Hartland/C64-Keyboard/Version 2 BETA/Docs/KEY HEADER TO CROSS SWITCH.pdf

C64 Keyboard Header Pin | Coordinate | MT8808 | MT8812/16
01 | GND | N/A | N/A
02 | N/C | N/C | N/C
03 | NMI | N/A | N/A
04 | +5V | N/A | N/A
05 | Y3 | 15 | 01
06 | Y6 | 12 | 17
07 | Y5 | 13 | 19
08 | Y4 | 14 | 21
09 | Y7 | 11 | 15
10 | Y2 | 16 | 39
11 | Y1 | 17 | 37
12 | Y0 | 18 | 35
13 | X0 | 06 | 33
14 | X6 | 09 | 08
15 | X5 | 21 | 28
16 | X4 | 08 | 29
17 | X3 | 22 | 30
18 | X2 | 07 | 31
19 | X1 | 23 | 32
20 | X7 | 20 | 09
