Hartland/C64-Keyboard/Version 2 BETA/Docs/NonAlphaNumKeys.PDF

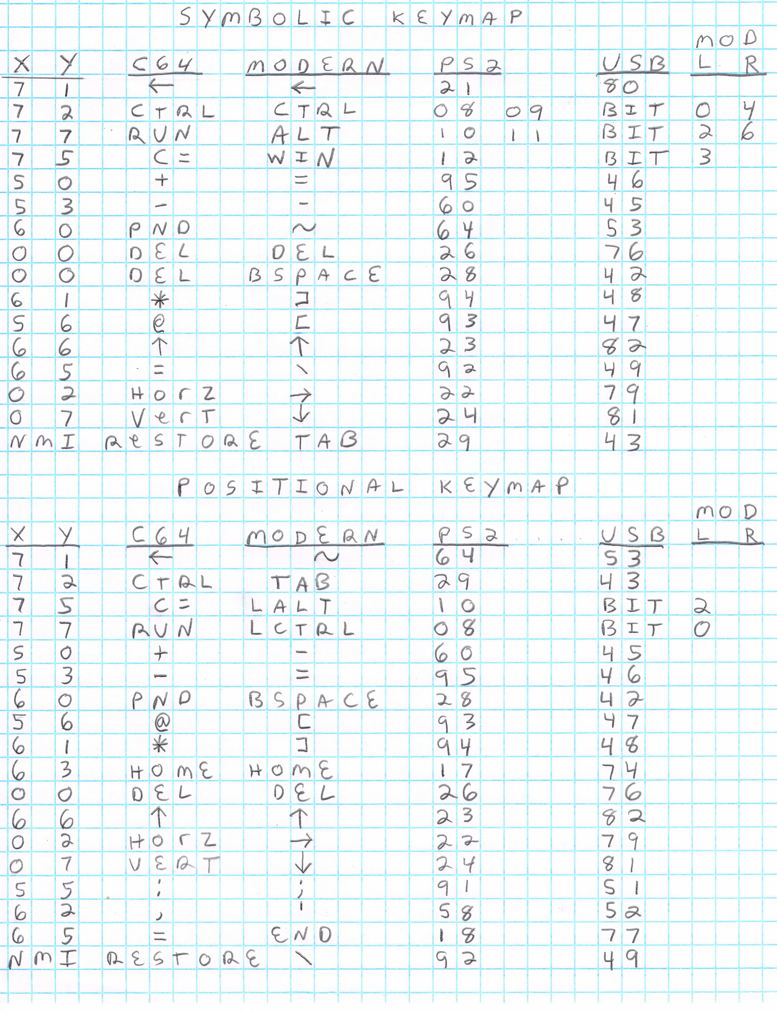
[picture p1: page 1]
