Hartland/C64-Keyboard/Version 2 BETA/Docs/PS2KeyAdvanced_Codes.PDF

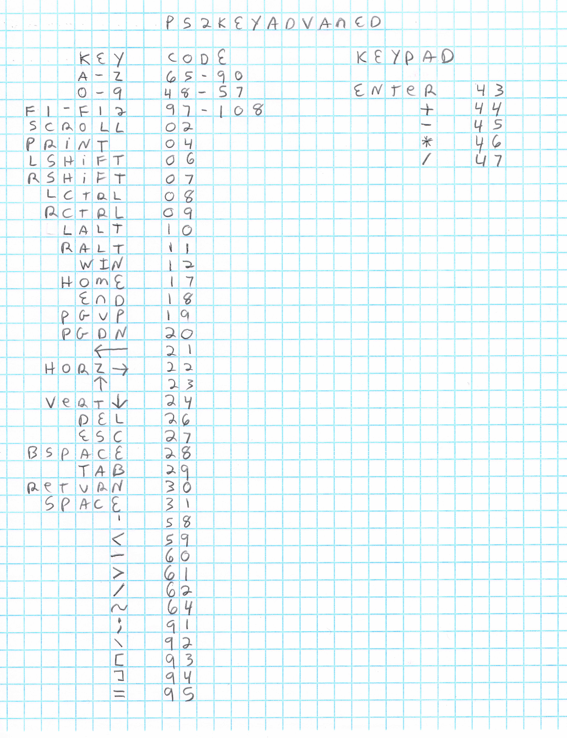
[picture p2: page 1]
