Hartland/C64-Keyboard/Version 2 BETA/Docs/KEY COORDINATES.pdf

KEY | AX | AY A | 1 | 2 B | 3 | 4 C | 2 | 4 D | 2 | 2 E | 1 | 6 F | 2 | 5 G | 3 | 2 H | 3 | 5 I | 4 | 1 J | 4 | 2 K | 4 | 5 L | 5 | 2 M | 4 | 4 N | 4 | 7 O | 4 | 6 P | 5 | 1 Q | 7 | 6 R | 2 | 1 S | 1 | 5 T | 2 | 6 U | 3 | 6 V | 3 | 7 W | 1 | 7 X | 2 | 7 Y | 3 | 1 Z | 1 | 4 0 | 4 | 3 1 | 7 | 0 2 | 7 | 3 3 | 1 | 0 4 | 1 | 3 5 | 2 | 0 6 | 2 | 3 7 | 3 | 0 8 | 3 | 3 9 | 4 | 0

KEY | AX | AY
HORZ CURSOR | 0 | 2
VERT CURSOR | 0 | 7
F1 | 0 | 4
F3 | 0 | 5
F5 | 0 | 6
F7 | 0 | 3
HOME | 6 | 3
UP ARROW | 6 | 6
= | 6 | 5
RIGHT SHIFT | 6 | 4
/ | 6
7 ; | 6 | 2 * | 6 | 1 . | 5 | 4 @ | 5 | 6 : | 5 | 5 + | 5 | 0 - | 5 | 3 , | 5 | 7
CTRL | 7 | 2
RUN/STOP | 7 | 7
SPACE | 7 | 4
C= | 7 | 5
LEFT SHIFT | 1 | 7
BACK ARROW | 7 | 1
DELETE | 0 | 0
RETURN | 0 | 1
POUND | 6 | 0
