Hartland/C64-Keyboard/Version 2 BETA/Docs/PS2KeyAdvanced_Codes.JPG

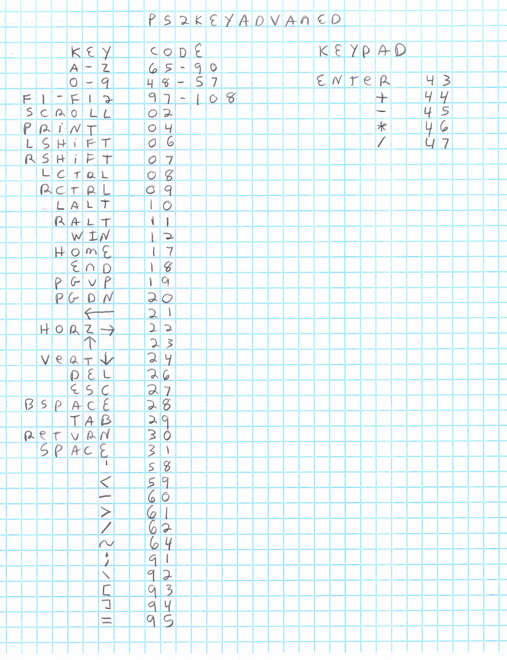
Version 2 BETA/Docs/PS2KeyAdvanced_Codes.JPG
