Hartland/C64-Keyboard/Version 2 BETA/Wiring difference.txt

This document is obsolete.

The MT88xx library now uses direct pin assignment for the address pins.

The current version of the PS/2 C64 keyboard sketch will work on current PCBs.

It has been tested with the shared C64 keyboard PCB from PCBWAY
