Hartland/C64-Keyboard/(threads)

Thread 1 (2020-01-11):

Build errors

StormTrooper, 2020-01-11:
Found a small error:
In the file C64-Keyboard/USB/C64_keyboard/C64_keyboard.ino you include:
"C64Keyboard.h"

It should "C64keyboard.h"

Hartland, 2020-01-14:
Filename case issue resolved in latest commit.
I did not discover due to Windows being agnostic to letter case in file names.

Thanks for the catch.

Closed 2020-01-14.

Thread 2 (2024-01-07):

PS/2 keyboard init problems

c1570, 2024-01-07:
It seems I'm stumbled upon a PS/2 keyboard (a cheap "Labtec 867571-0102") that has some issues with the startup timing.

Setup: ATmega8, 8MHz internal clock, 64ms startup, 4V BOD, rather long power lines.

Symptom:

- power on the adapter
- press a key
- data line goes and stays low, adapter seems to hang
- resetting the ATmega8 (pull pin 1 to GND briefly) with power kept on makes things work again.

I suspect the problem is power related as this doesn't happen that often with very strong power supply/very short power lines. Perhaps the ATmega powers on much before the keyboard does, bringing them out of sync or similar.

In any case, disabling the setLock() call in resetMT8808() seems to fix the issue. I suspect delaying that somewhat would also be fine.

banman11, 2024-03-11:
Hi c1570,

Yes, I have found a few keyboards that have the same issue.
Just some random thoughts......

I found that unplugging the keyboard from the adaptor while the adaptor is plugged in to the c64 main board and powerd on seems to resolve my issue of the keyboard 'not being seen'.
The issue presents itself on several VIC 20's
, C64's, and a c16 that I tested.
I tried different external crystal speeds and internal speed configurations.
It must lay in the way the PS2/ USB keyboard communicates.
I had thought of putting in a push button along the 5v line to the PS2 / USB keyboard. When depressed would cut the power and hopefully reinitialise the keyboard after the Arduino microcontroller had a chance to boot up and become ready to process data.

Hartland, 2024-03-11:
It appears in the latest version of schematics, I omitted the bypass capacitor.
Placing a 100NF (.1uf) capacitor between VCC and ground can help with some of the glitching.

I will correct in the next revision. i will be revisiting the project this year and I am looking to include PCB transfers and possible fix for power up key detection.

banman11, 2024-03-12:
Hi Hartland,

Thanks for the prompt response. This is a great project. I see quite a few PS2/USB keyboard to C64 builders have used your code.

I wondered if I could ask for some advice. I don't see a questions tab in this GitHub profile. Only an issues tab. Could I use the issues tab to ask for advice or is there a better way?

I will look forward to seeing your next revision.

Regards..

sarumpaet, 2024-03-12:
> It appears in the latest version of schematics, I omitted the bypass capacitor.
> Placing a 100NF (.1uf) capacitor between VCC and ground can help with some of the glitching.

I forgot to mention that I already added additional capacitors to rule that out.

It looks like the PS2KeyAdvanced lib goes into some weird state in case setLock() gets called before the keyboard is actually ready. I haven't investigated further, but it looks like one has to wait for the 0xAA/BAT message from the keyboard after power on before sending control codes.

c1570, 2024-03-12:
> It appears in the latest version of schematics, I omitted the bypass capacitor.
> Placing a 100NF (.1uf) capacitor between VCC and ground can help with some of the glitching.

I forgot to mention that I already added additional capacitors to rule that out.

It looks like the PS2KeyAdvanced lib goes into some weird state in case setLock() gets called before the keyboard is actually ready. I suspect one has to wait for the 0xAA/BAT message from the keyboard after power on before sending control codes.

Hartland, 2024-03-16:
Banman11,

I believe the discussion tab is now available.

Responses may be a bit slow as my day job is entering the busier season.

As for the keyboard issue, has anybody tried to add a delay before ps2advanced is loaded?
I am in the process of getting my C64 project bench setup up and running, while finishing off a couple of my personal projects, so I have not been able to look directly into this.
Also, could you give me some model numbers of the keyboards that are having issues. i have not encountered this issue with any keyboards I have used and I will need to get one of the model keyboards that are having this issue.

banman11, 2024-03-17:
Hi Hartland,

First of all I would like to you for this great project.

Much appreciated for adding the discussion tab.😁

No, I haven't added a delay before the ps2advanced is loaded. This may actually be a good way to check it.
I have a theory that some of the keyboards I tested needed some type of delay.

I must apologise, I am a very mediocre hobbyist at best.
What would the code snippet look like if a delay were added.

I definitely will let you know the types of keyboard that works and doesn't work.
I did notice that some USB keyboards functioned perfectly fine with the PS2 programmed firmware.
So I would say that some USB keyboards use PS2 style protocols.

A few of us started this thread....

https://www.melon64.com/forum/viewtopic.php?t=15160&hilit=Usb+keyboard

We had tried to contact you some time ago to get permission to use your project. However we got no reply.
I do apologize very much if we have done the wrong thing. We can pull the thread down if you wish. Please let us know. We would be happy to comply.

Hartland, 2024-04-20:
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

No issues, I always meant this project to be available to all hobbyists. In fact ,I will be changing to a MIT license during the updates planned this year.
I have tried to register at melon64 a couple of times, but I never receive the email verification. Perhaps give the admin a poke to check out the verification system.

Also, I have published the overall plan this year in the discussion forum.

banman11, 2024-04-21:
Hello Heartland,

Thank you very much for your blessing.

It would absolutely be our pleasure if you would join us on Melon64. It would be a great opportunity for us hobbyist's have your views and inputs. There are so many things I want to know regarding your great work. Melon64 is a good easy forum for off the cuff discussion of things with an incline towards retro computer related stuff.
I will see what I can do about resolving your login verification issues.
I am sure it is some minor clerical technicality. I'll get back to you.

Thanks again for a great project.

Hartland, 2024-04-25:
Quick update on the issue itself.
I recently bought a 2nd PS/2 keyboard for backup. I have learned it can be easy to fry a PS/2 keyboard through the development of the project.
It turns out the new keyboard exhibits the issue described.

It appears it is an issue with PS2key advanced itself. The same issue arises when just the library with its included example, at least with the UNO. I remember testing it the DUE and it worked, but I am going to need to explore further.
The new keyboard works fine on a computer and the old keyboard works with PS/2 key advanced with no changes to the UNO.

It looks like I might need to "adjust" another library. In this case maybe fix an issue the library writers refuse to acknowledge and seem to push issue on the user.
It is still possible I may be at fault, but with the simple test of old and new keyboard on the same UNO with no changes, it seems unlikely,

banman11, 2024-04-26:
Hi Hartland,

Well, I can say I that I haven't had and issues with breaking any keyboards using your current circuit layout.
I even accidentally reversed the pin header on a C16 Commodore computer and absolutely nothing untoward happens. However, I absolutely don't recommend that one tries this of course.

At the time I thought the C16 machine is finished.

I would hazard a guess the crosspoint IC chip you have implemented has safety cutoff features.
That's a sign of good engineering, thanks.

Hartland, 2024-04-26:
Sorry for any confusion my previous posted caused. I was only commenting on the frailty of some PS/2 keyboards i have experienced in the past, nothing to do with recent activity.

I am most probably incorrect about the delay, I do not think it will fix anything. There may be some timing issues, but for now out that aside.

I have discovered 2 issues:

In terms of initialization, there may be voltage problems. The new keyboard will not initialize correctly at 5V but will initialize at 5.25V. These are measurements on the power supply and multi-meter at PS/2 connector.

The newer keyboard  appears to send twice as much data per key press then the older keyboard. There are several variations on the PS/2 scan code sets even within the sets themselves.

I will keep you posted as developments occur.

Hartland, 2024-04-27:
Update:

I have figured out the base difference between the PS/2 keyboards that work with any of the PS/2 libraries I have tested and those that do not.

USB compatibility is the difference.

Internally, keyboards that are strictly PS/2 work fine. Those that work with both USB and PS/2, including those that have wired PS/2 connectors, have issues with deciding what protocol to use.

When using a dual protocol keyboard:

1. At 5.25V the keyboard will initialize with PS/2. However, it sends what appears to be corrupted/random data that is different each time regards of key press. It appears this is USB packet data.

2. Using a PS/2 breakout board and connecting to a computer through USB results in a fully functional USB keyboard. Normal power though USB is used.

3. Connecting both USB to computer and PS/2 to micro controller at the same time results in no USB connection but a stable PS/2 connection (though the key-codes are a bit odd, could be a code set issue). No extra data, just normal make/break packets. Again, normal USB power is used.

Updates to continue, when I figure out more.

c1570, 2024-04-28:
@Hartland Not sure if your findings are actually related to the original description of this issue. Have you tried removing the setLock() call in resetMT8808() ? If that fixes the issue, then it's clearly related, if not, a new issue should get opened.

Perhaps the early setLock() call triggers some USB detection on keyboard side? And that only happens if - due to supply voltage/power line length/resistance - the keyboard is a bit late when initializing?

Hartland, 2024-04-28:
I deleted a few of my posts as they are no longer relevant and do not provide useful information. I have a tendency to share in my troubleshooting process in hopes of somebody will have some helpful insights.  After tentatively fixing the issue, I thought it appropriate to cleanup a bit.

I believe I have a solution to the PS/2 initialization issue that may or may not be be related to this issue.

On certain PS/2 - USB combo keyboards, including those with only a wired PS/2 connector, there appears to be something different with the pull-up resistance on both data and clock lines. Whether or not the micro-controller has the pins set as pull-up makes no difference.
Installing 4.7K or 10K pull-up resistors(again regardless of the micro-controller settings) fixes the initialization and protocol issue.
Some keyboards still seem to send extra packets when a key is held down, but I will investigate and issue a fix if needed.

For those unfamiliar with pull up resistors, it is simply adding a resistor from V+ to clock and data pins separately (each pin has its own resistor).

If this does not help with the OP issue, I will separate this into a new issue.

banman11, 2024-04-29:
Hi Heartland,

Very interesting!
I think I have a few keyboards that have a USB cable which will work on the PS2 programmed adapter after I disconect and reconnect the keyboard cable while the adapter 8s powered up.

Thank you for the tip on using the 4.7k -10k Ohm pullup resistor between the + 5v power rail and the Clock and Data separately.

I'll get back to you with my observations.

Thanks

Hartland, 2024-06-06:
As mentioned in in the discussion post, I found that 220 ohm resistors work best. At least with the keyboard I experimented with, that value really brought it under control and working smoothly.
