Hartland/C64-Keyboard/Version 1/PS2/Arduino Uno-Nano MT8808 schematic.pdf

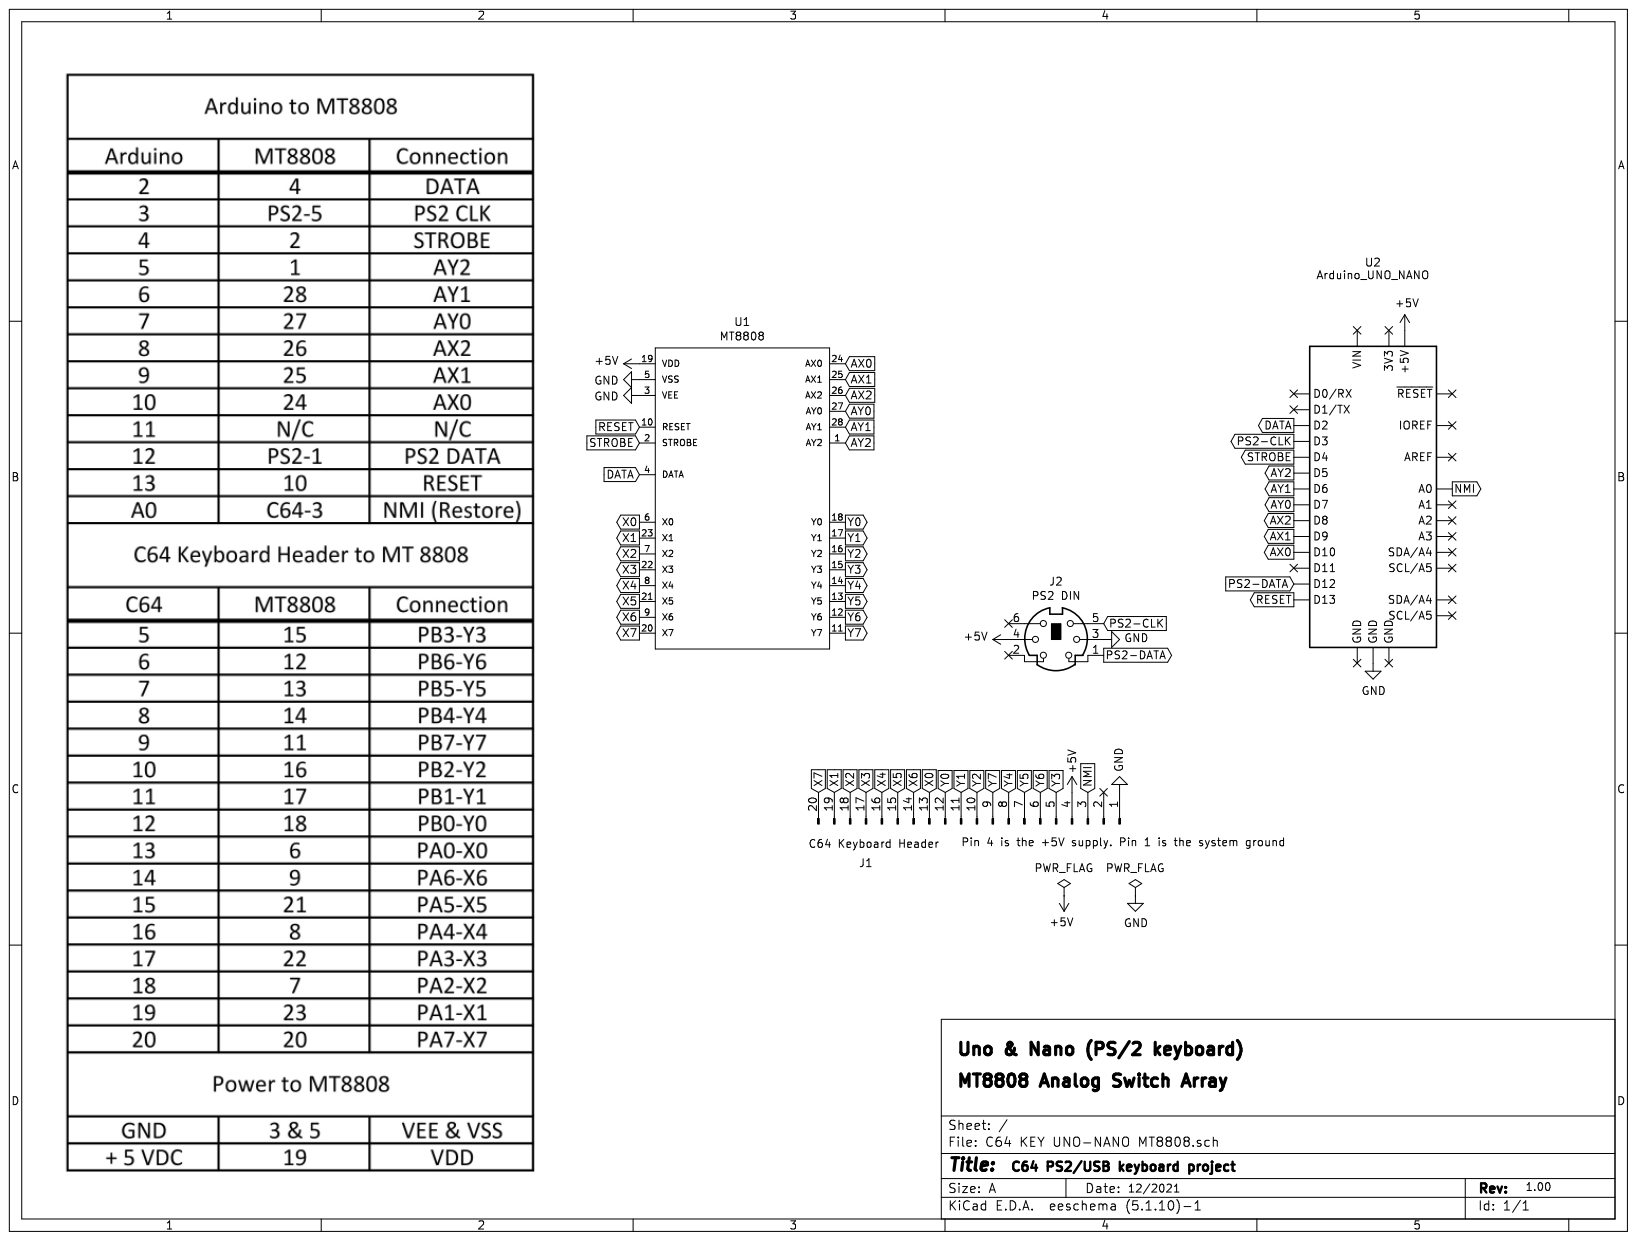
[picture p4: page 1]
