Hartland/C64-Keyboard/Version 1/PS2/Arduino Uno-Nano MT8812-16 schematic.pdf

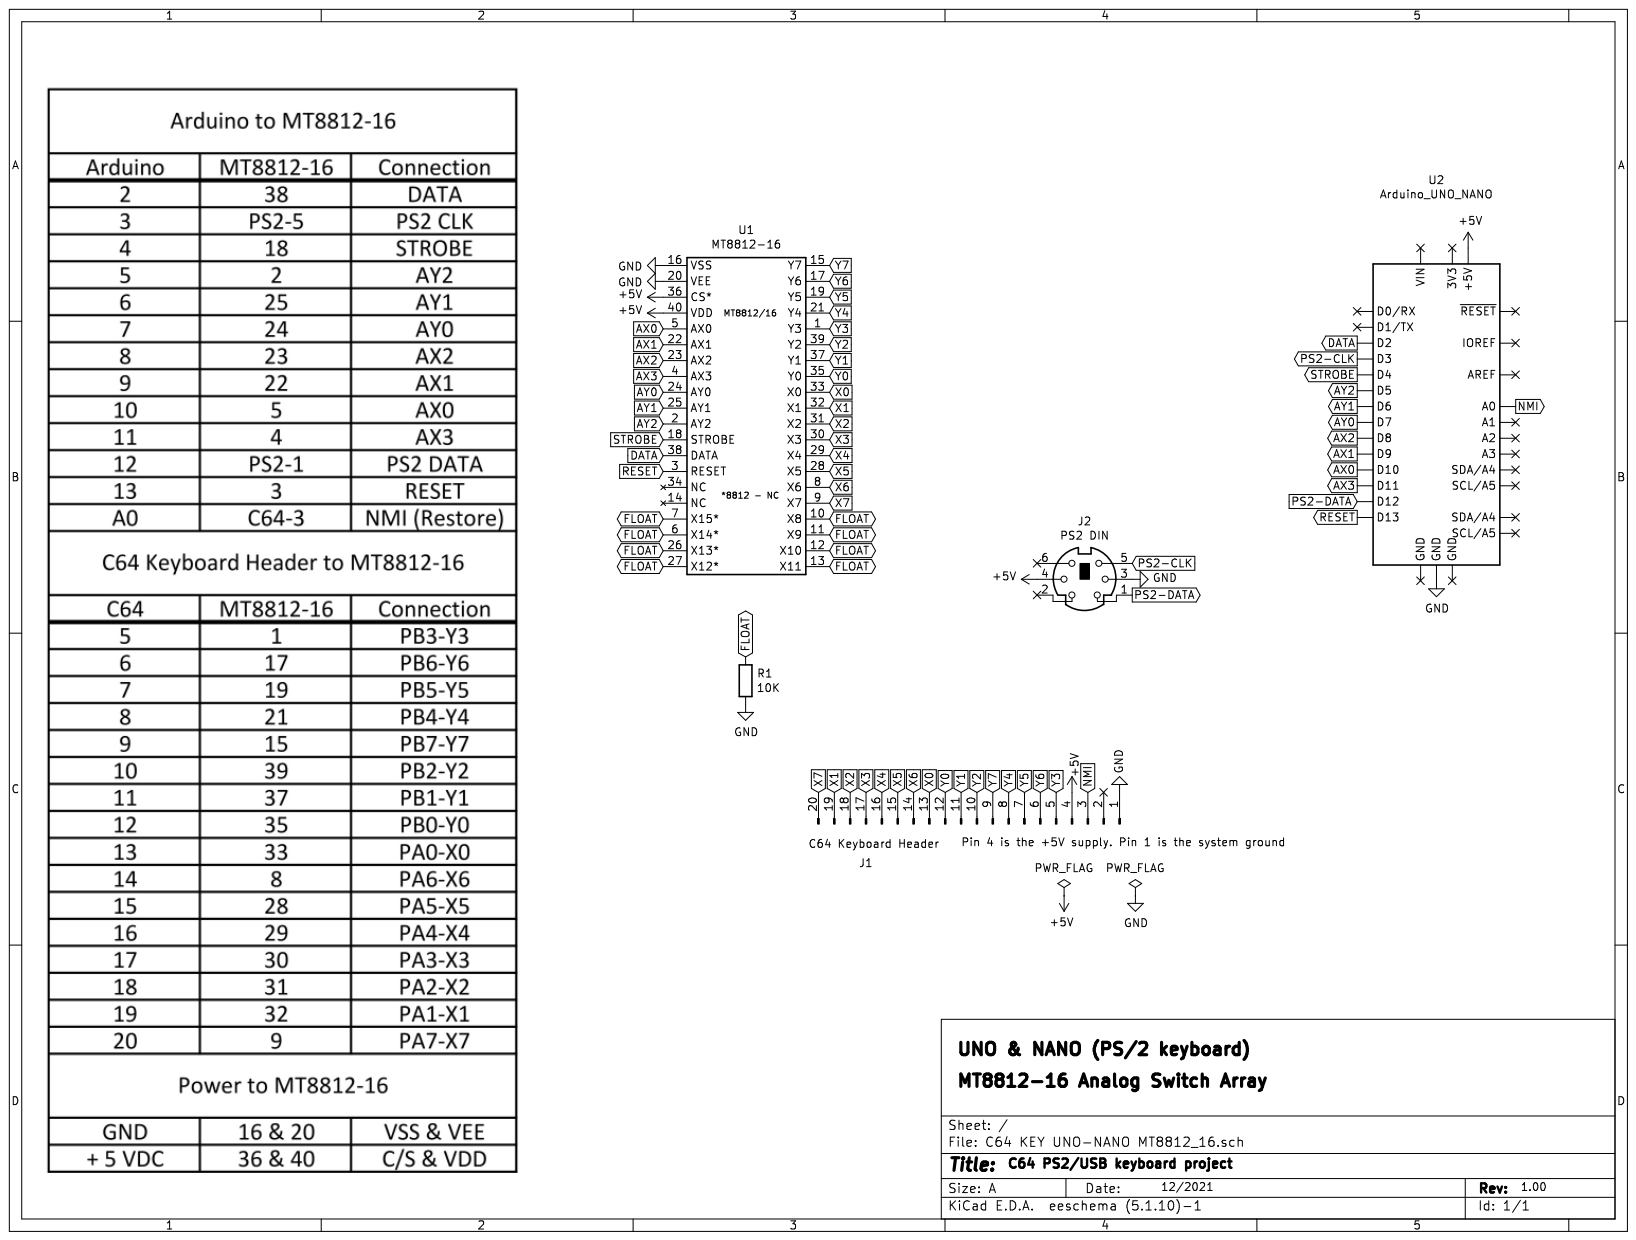
[picture p5: page 1]
