Hartland/C64-Keyboard/USB/doc/Schematic _MT8808.pdf

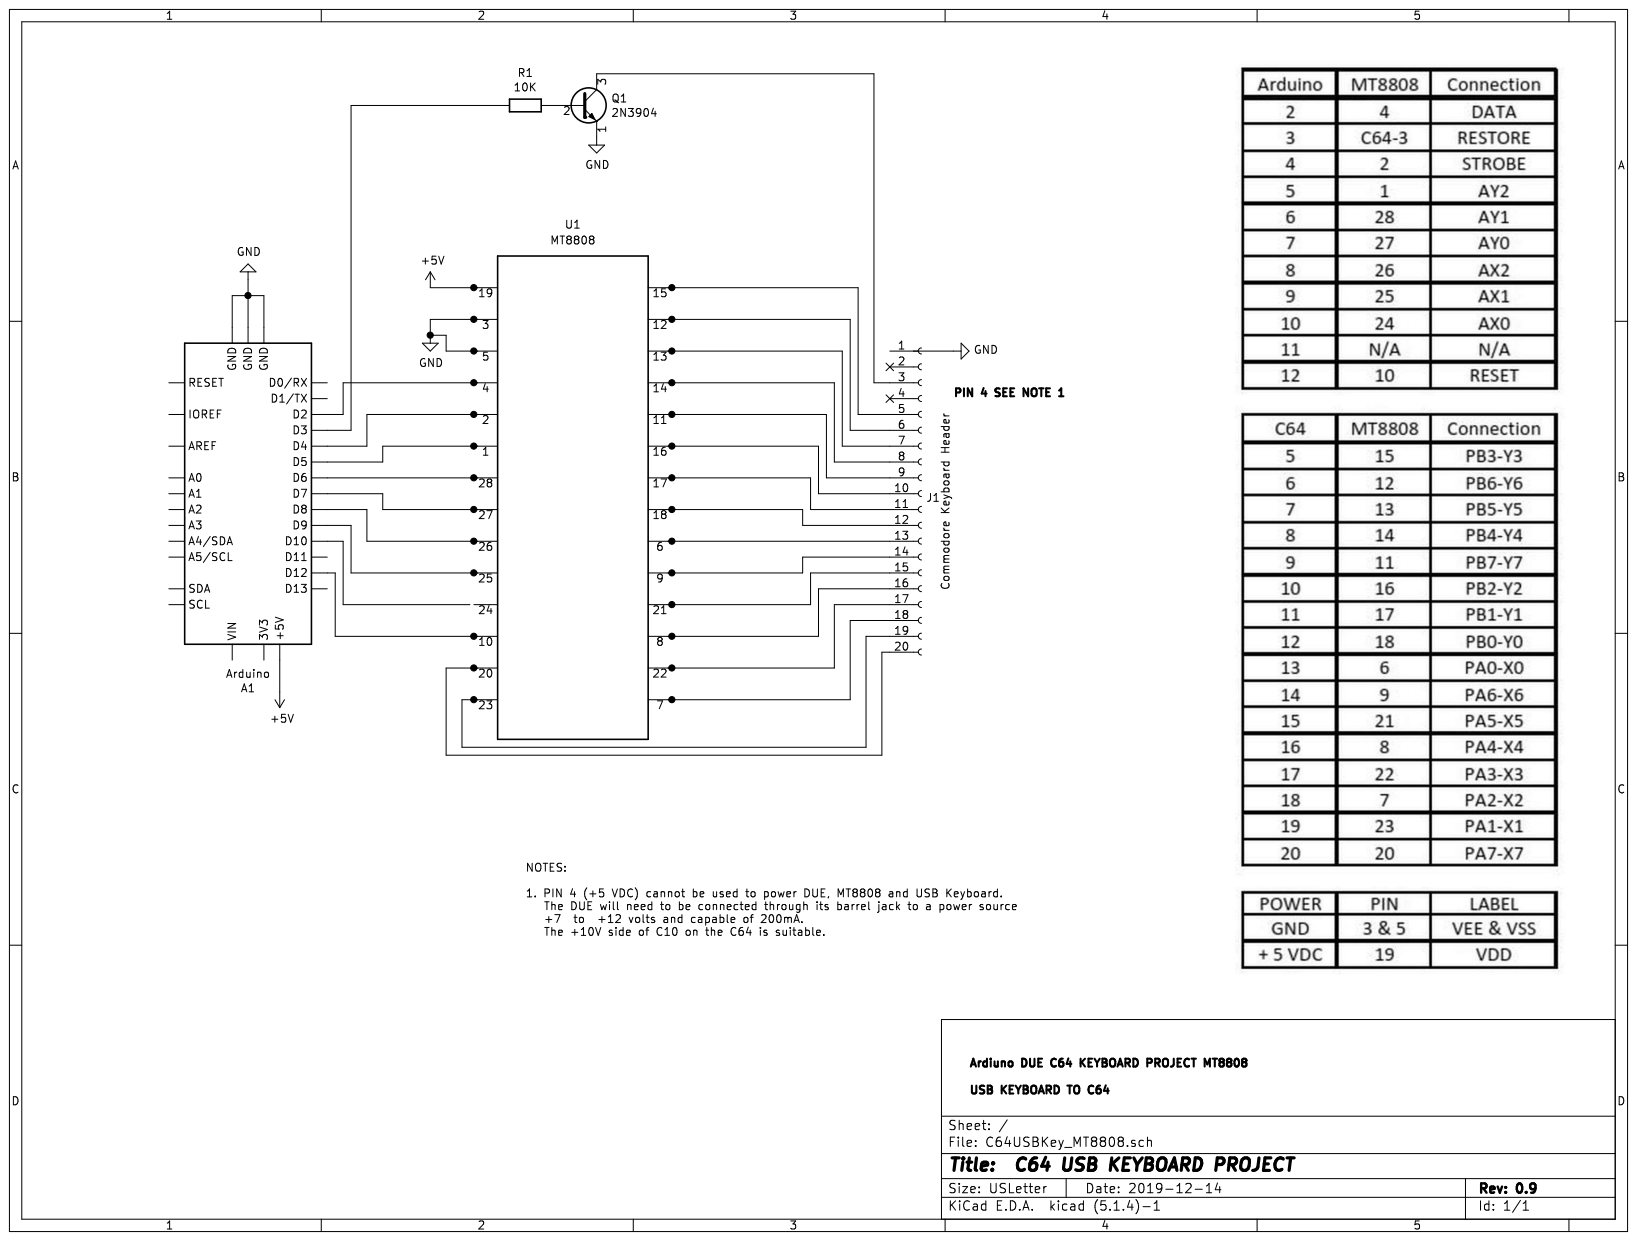
[picture p6: page 1]
