Hartland/C64-Keyboard/USB/doc/Schematic _MT8812-16.pdf

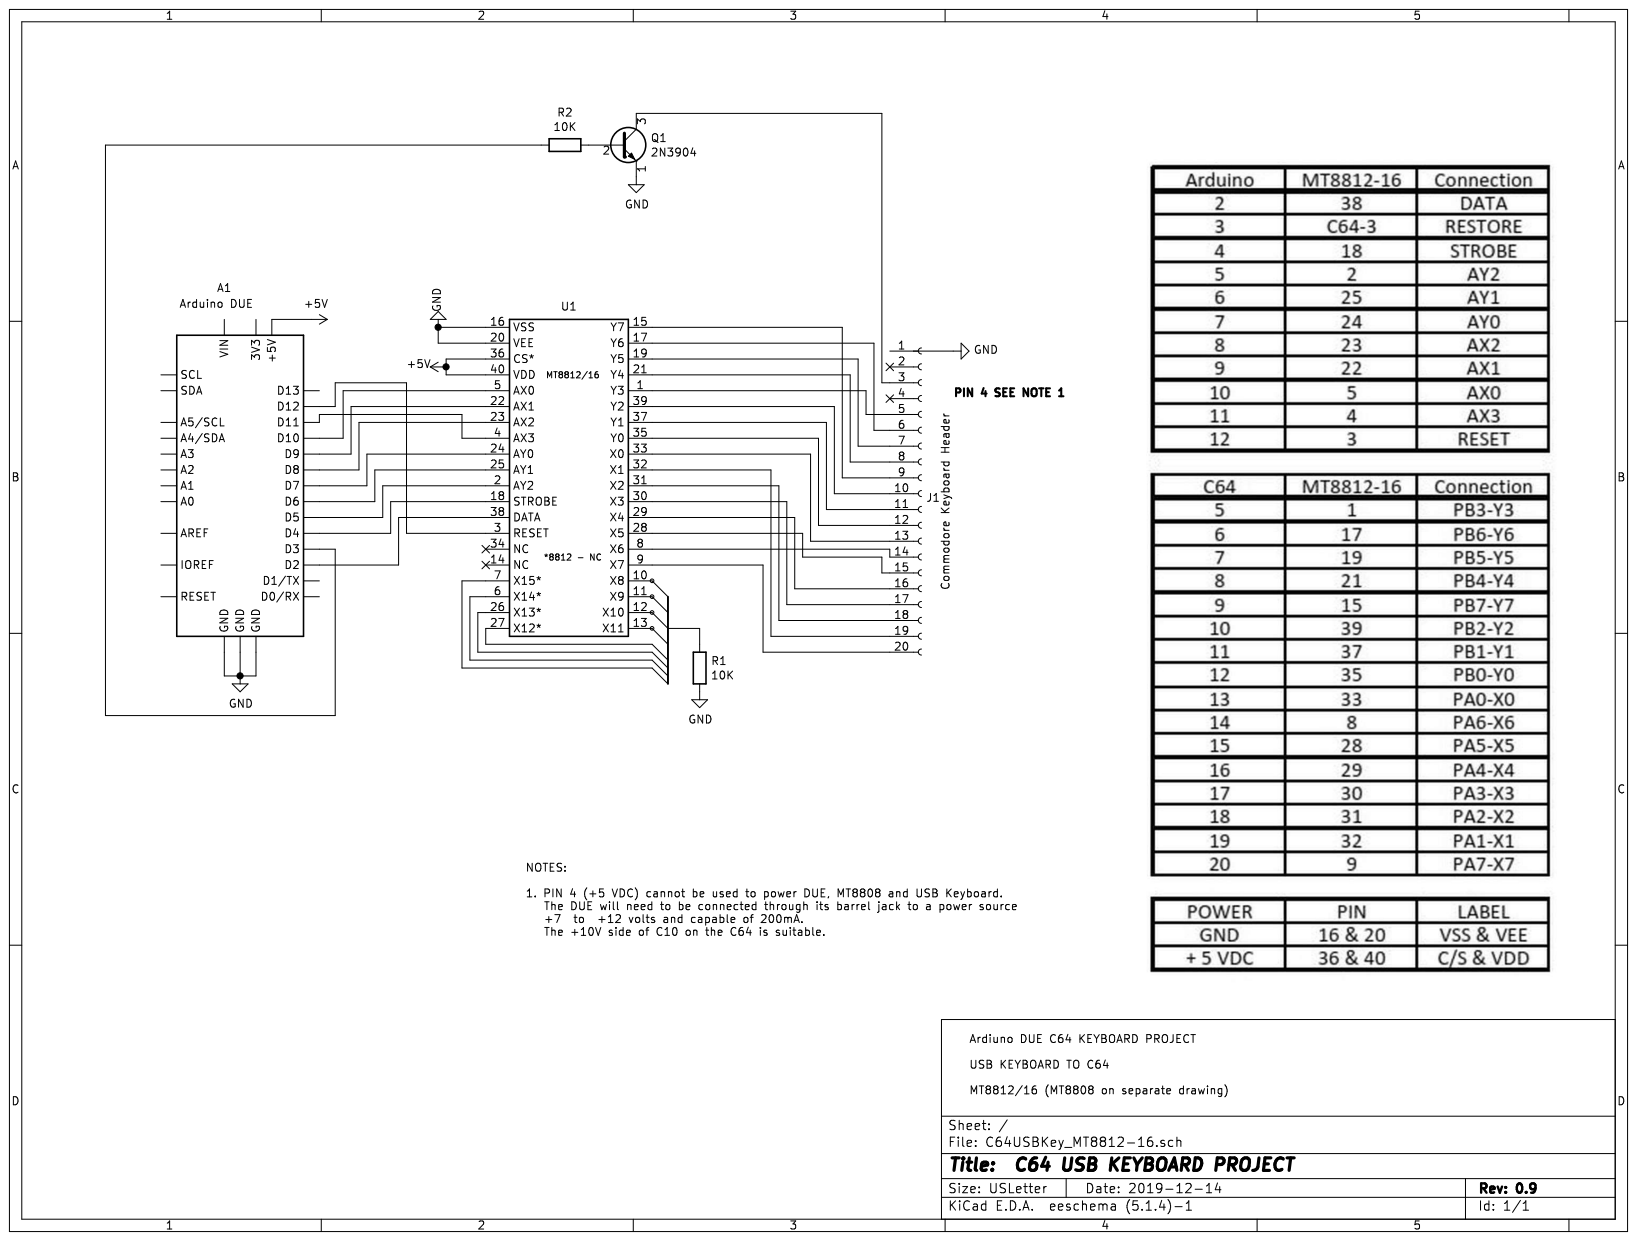
[picture p7: page 1]
