Hartland/C64-Keyboard/Version 1/USB/DUE/DUE MT8808 schematic.pdf

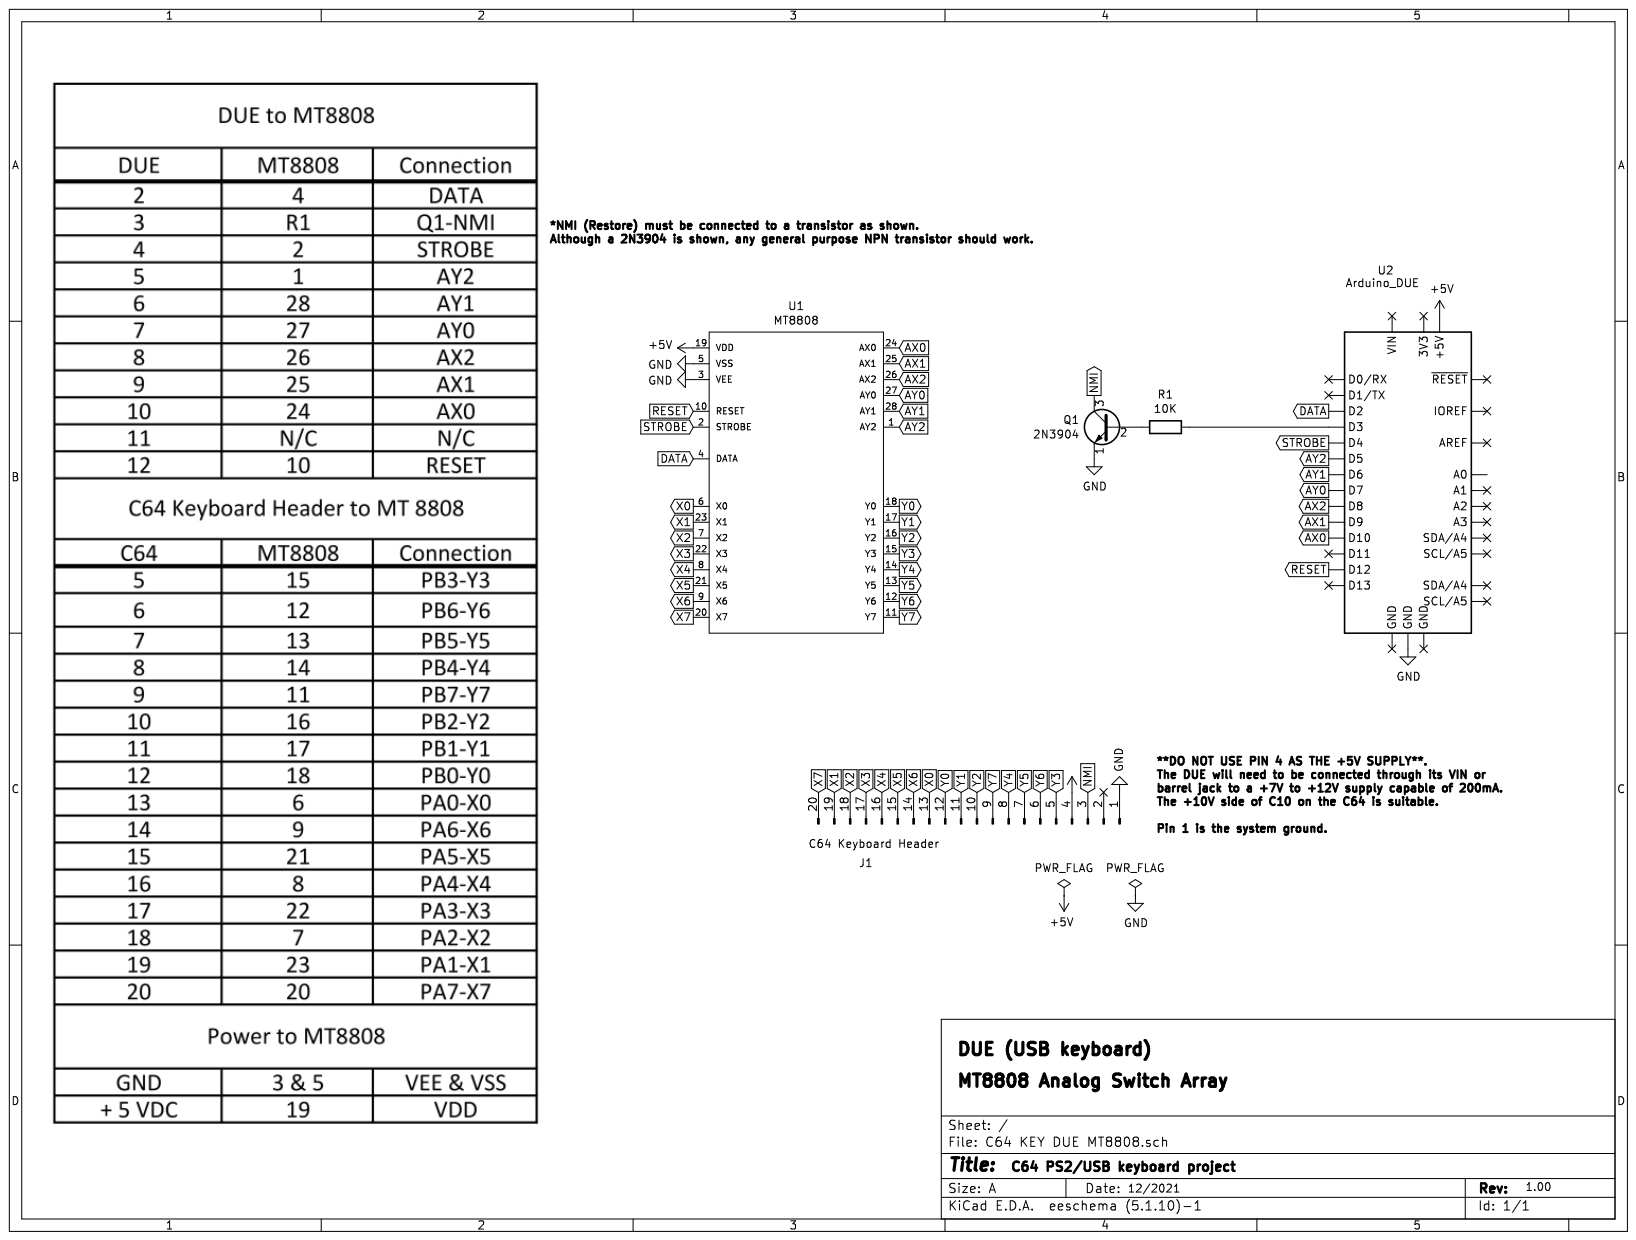
[picture p8: page 1]
