Hartland/C64-Keyboard/Version 1/USB/DUE/DUE MT8812-16 schematic.pdf

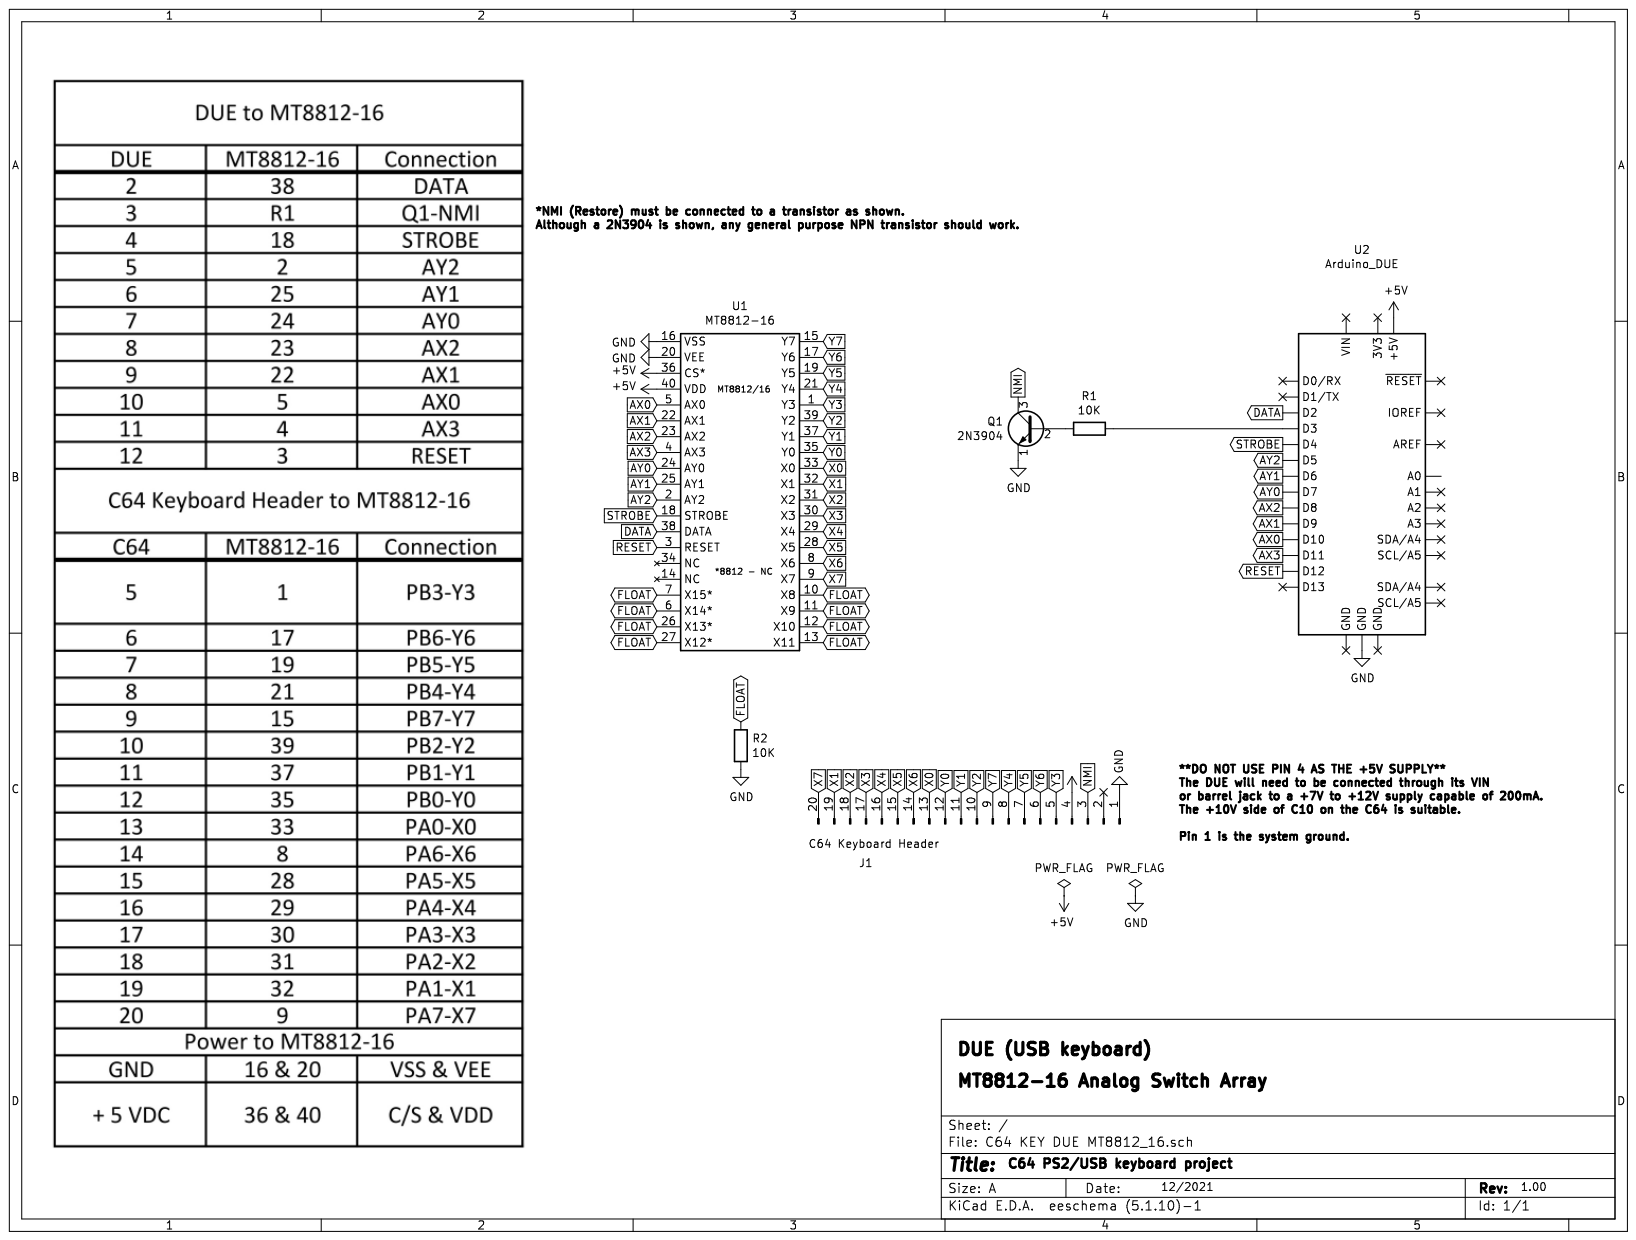
[picture p9: page 1]
