Hartland/C64-Keyboard/Version 1/USB/SEEED/SEEED MT8808 schematic.pdf

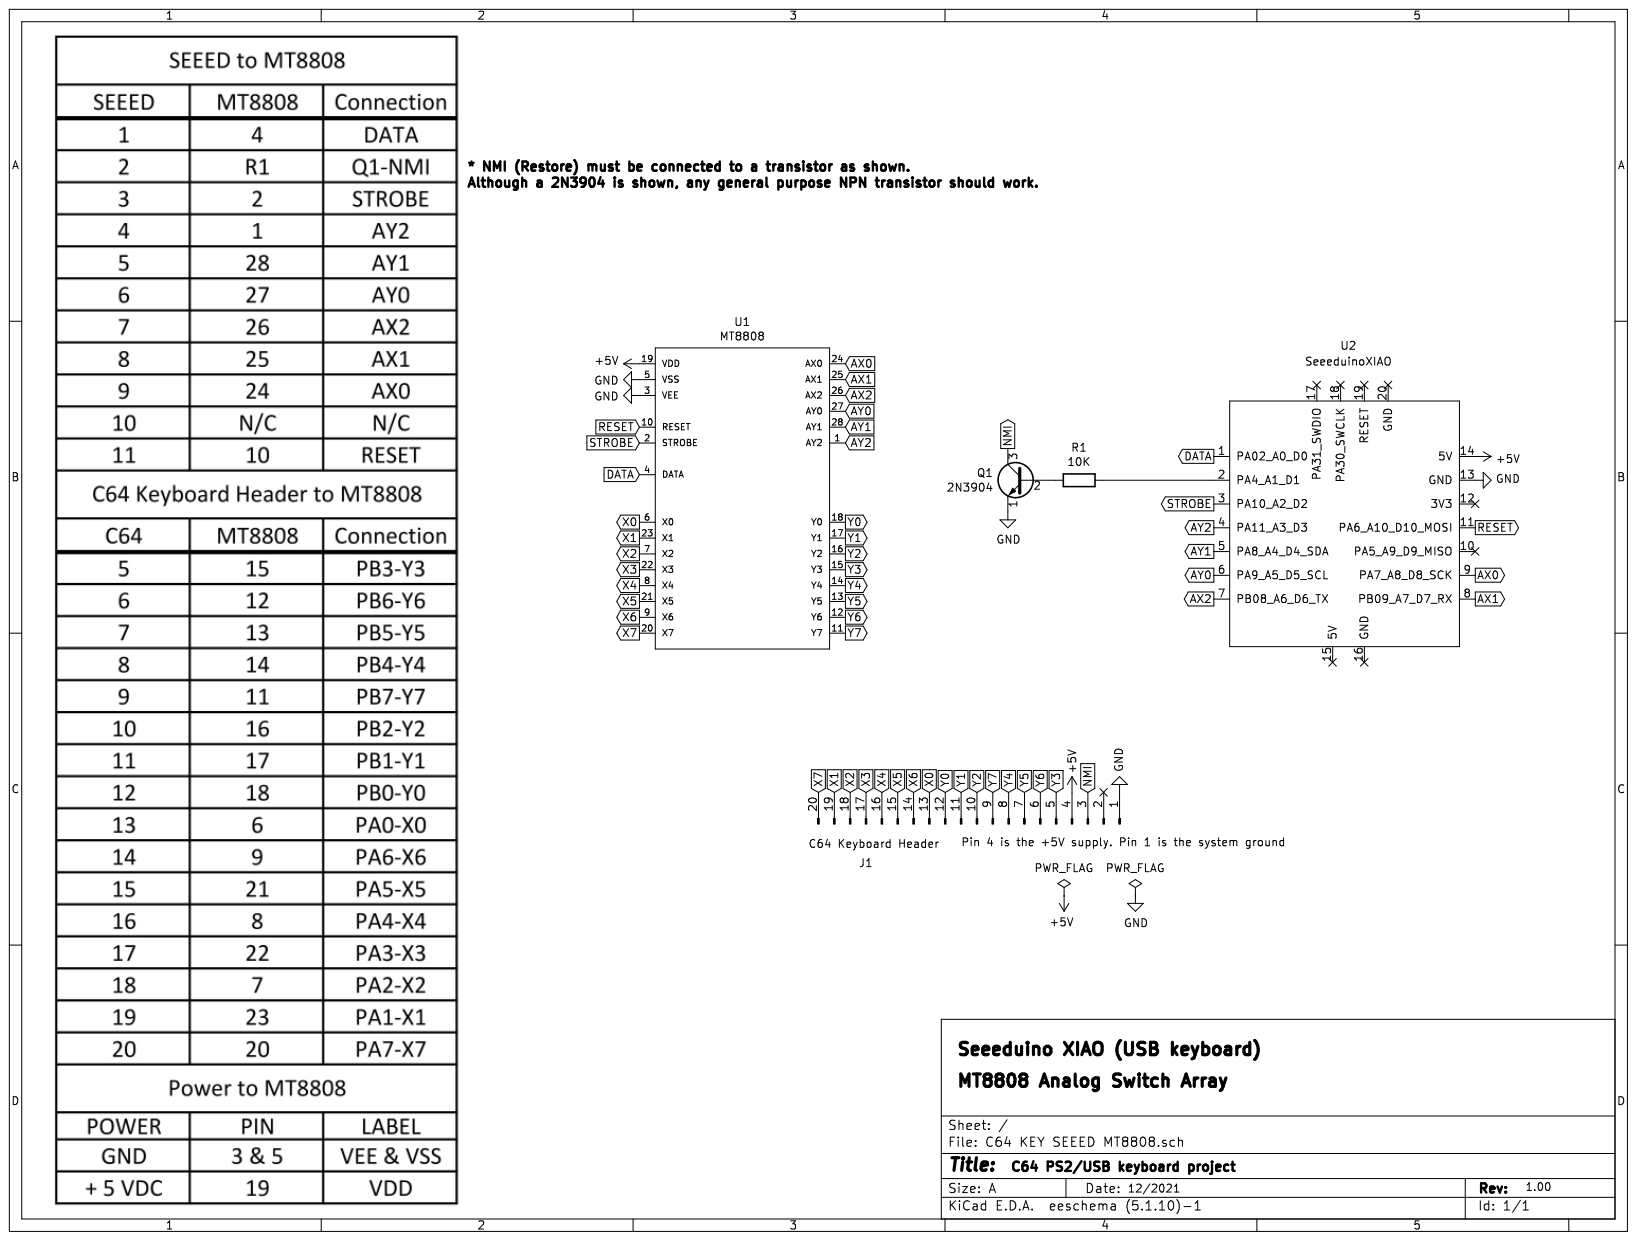
[picture p10: page 1]
