Hartland/C64-Keyboard/Version 1/USB/SEEED/SEEED MT8812-16 schematic.pdf

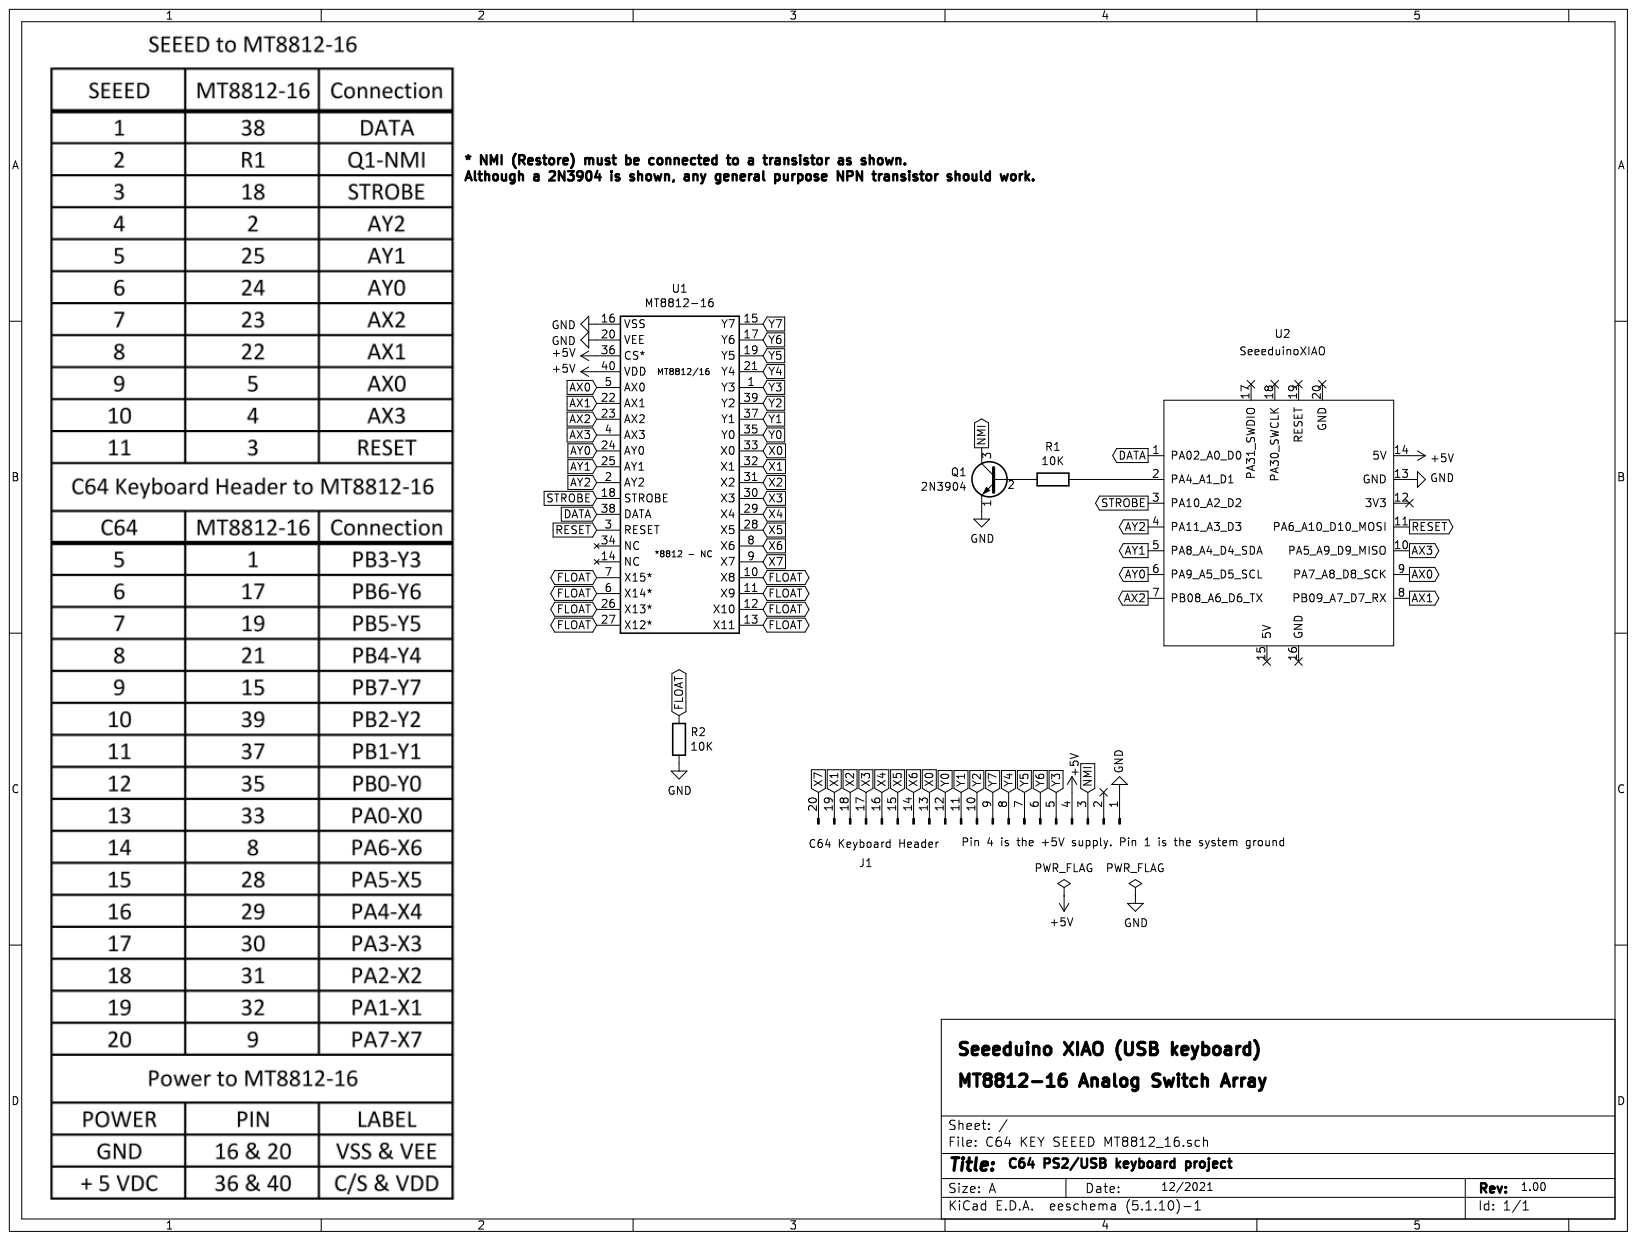
[picture p11: page 1]
