Hartland/C64-Keyboard/Version 1/PS2/C64_keyboard/C64keyboard.c.ino

/*
  C64keyboard.h - Commodore Keyboard library

  Copyright (c) 2022 Hartland PC LLC
  Written by Robert VanHazinga


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
  You should have received a copy of the GNU Lesser General Public
  License along with this library; if not, write to the Free Software
  Foundation, Inc., 51 Franklin St, Fifth Floor, Boston, MA  02110-1301  USA
*/
#include "C64keyboard.h"



void resetMT88(void) {
  digitalWrite(ANALOG_SW_DATA , LOW);
  digitalWrite(ANALOG_SW_RESET, HIGH);
  digitalWrite( ANALOG_SW_STROBE, HIGH);
  digitalWrite(ANALOG_SW_RESET, LOW);
  digitalWrite( ANALOG_SW_STROBE, LOW);
  digitalWrite(ANALOG_SW_DATA , HIGH);
  keyboard.setLock (PS2_LOCK_SCROLL && 0);
  capslock = false;
  lshift = false;
  rshift = false;
  currkeymap = 1;
  }

void setswitch(uint8_t c){
  int bitr;
  bool state;
  // Fix logic table hole in MT8812/16
  // Convert x12 & x13 to x6 & x7. AX3 line control
  if ( !MT8808 &&( (c > 55 && c < 64) || (c > 23 && c < 32 ))) {
     c -= 24;
    digitalWrite(ANALOG_SW_AX3, HIGH);
  }
    
  if (c < 64) {
    for ( int currentPin = ANALOG_SW_ARRAY_START; currentPin <= ANALOG_SW_ARRAY_END; ++currentPin) {
      bitr = (currentPin - ANALOG_SW_ARRAY_START);
      state =  bitRead(c, bitr);
      digitalWrite(currentPin, state);
    }
    digitalWrite( ANALOG_SW_STROBE, HIGH);
    digitalWrite( ANALOG_SW_STROBE, LOW);
  }
  if (!MT8808){digitalWrite(ANALOG_SW_AX3, LOW);}

}

void debugkey (uint8_t c,uint8_t flags,uint8_t kc){
    Serial.print ("C64 Keycode: ");
    Serial.print (c);
    Serial.print ("  (ASCII Code: ");
    Serial.print (kc);
    Serial.print (" Hex: ");
    Serial.print (kc, HEX);
    Serial.print (")  Flags: ");
      for (int i = 7; i >= 0; i--)
    {
        bool b = bitRead(flags, i);
        Serial.print(b);
    }
    Serial.println();
  }
    
  

  
void c64key(uint16_t k) {
   flags = k >> 8;
   uint8_t kc= k & 0xFF;
   uint8_t c = 0;

  if (currkeymap == 2) {
    if (bitRead(flags, 6)) {
      c = pgm_read_byte(keymap->shift_2 + kc);
    }
    else {
      c = pgm_read_byte(keymap->noshift_2 + kc);
    }
  }


   if (currkeymap == 1) {
    if (bitRead(flags, 6)) {
      c = pgm_read_byte(keymap->shift_1 + kc);
    }
    else {
      c = pgm_read_byte(keymap->noshift_1 + kc);
    }
  }
//  debug output
    if (debug){debugkey(c,flags,kc);}

// Ignore extended codes 
    if (kc == 250){c=IGNORE_KEYCODE;}
    
    
// MT reset function    
    if (kc == MT_RESET) {
    resetMT88();  
    c=IGNORE_KEYCODE;
   }   
   
// Restore key function   
    if (kc == RESTORE_KEY){
      if (bitRead (flags,7)){pinMode (NMI_PIN,INPUT);
     }
      if (!bitRead (flags,7)) {pinMode (NMI_PIN, OUTPUT);
        digitalWrite (NMI_PIN,LOW);
        }
      c = IGNORE_KEYCODE;
   }
   
// Capslock function 
    if (kc == CAPSLOCK_KEY) {
      capslock = !capslock;
      digitalWrite (ANALOG_SW_DATA, capslock);
      setswitch(39);
      c = IGNORE_KEYCODE; 
      }

// Keymap Handling
    if (kc == KEY_MAP_1 && !bitRead(flags,7)){
      currkeymap = 1;
      keyboard.setLock (PS2_LOCK_SCROLL && 0);
      }

    if (kc == KEY_MAP_2 && !bitRead(flags,7)){
      currkeymap = 2;
      keyboard.setLock (PS2_LOCK_SCROLL && 1);
      }
        
// Jump to end if key code is an ignored key
    if (c != IGNORE_KEYCODE) {
    // Differential shift conversion during key press
   if (c >= 64 ) {
      c -= 64;
      if (rshift || lshift) {
        digitalWrite (ANALOG_SW_DATA, LOW);
        setswitch(25);
        digitalWrite (ANALOG_SW_DATA, LOW);
        setswitch(39);   
      }
      
     else {
        digitalWrite (ANALOG_SW_DATA, HIGH);
        setswitch(39);
      }
      // Set cross switch key
      digitalWrite(ANALOG_SW_DATA, HIGH);
      setswitch(c);
       if bitRead (flags,7){
      // Restore shift state to match keystate
      digitalWrite (ANALOG_SW_DATA, lshift);
      setswitch(39);
      digitalWrite (ANALOG_SW_DATA, rshift);
      setswitch(25);
      digitalWrite(ANALOG_SW_DATA, HIGH);
     }
   }
// Shift key handling
     if bitRead (flags,6){
   
      if (c == 25) {rshift = true;}
      if (c == 39) {lshift = true;}
      }
  
    if bitRead (flags,7){
      digitalWrite(ANALOG_SW_DATA , LOW);
        if (c==25) {rshift = false;}
        if (c==39) {lshift = false;}
        }
        
  // Process normal keypress
    if (c != IGNORE_KEYCODE){setswitch(c);}      
 }

// Reset switch state pin to default high state (Key press).
    digitalWrite(ANALOG_SW_DATA , HIGH);
}

  

void C64keyboard::begin(const C64Keymap_t &map) {

  keymap = &map;

  // initialize the pins

  for ( int currentPin = ANALOG_SW_ARRAY_START; currentPin <= ANALOG_SW_ARRAY_END; ++currentPin) {
    pinMode( currentPin, OUTPUT);
  }

  if (!MT8808){pinMode( ANALOG_SW_AX3, OUTPUT);}  // ANALOG_SW_AX3 (AX3) is separate as it is used only for conversion of X12/X13 into X6/X7
  pinMode( ANALOG_SW_STROBE, OUTPUT);  // MT88XX strobe
  pinMode( ANALOG_SW_DATA, OUTPUT);   // MT88XX data
  pinMode( ANALOG_SW_RESET, OUTPUT); // MT88XX reset
  pinMode(ANALOG_SW_DATA, OUTPUT);  //MT88XX data
  pinMode(NMI_PIN, INPUT); // C64 NMI

  resetMT88();
  

}
C64keyboard::C64keyboard() {
  // nothing to do here, begin() does it all
}
