Hartland/C64-Keyboard/(commit log)

2015-10-28 Add schematic
2019-11-16 Create Schematic _MT8812-16.pdf
2019-12-01 Updated MT8812-16 schematic
2020-01-14 Correct filename case
2021-04-06 Version 0.920
    Add SEEED board for USB
2021-12-31 Version 1.00
    Document cleanup and schematics for SEEED XIAO.
    [KEYBIN.xlsx]
2024-05-28 Version 2 setup
    Rearrange repository in preparation of version 2. Version 1 has been moved to archive and the beta of PS/2 version 2 has been uploaded. The documents mapping out keyboard header to switch array connections and C64 keys to AX & AY coordinates has been published.
    VERSION 2 DOES NOT WORK WITH VERSION 1 HARDWARE. THE ABILITY TO USE VERSION 1 HARDWARE with VERSION 2 WILL BE IMPLENTED SHORTLY.
    [KEYBIN.xlsx]
2024-05-28 Revert to fix directory
    [C64_keyboard.ino, C64keyboard.cpp, C64keyboard.h, keymapping.h]
2024-05-29 Improve repository layout
    [KEYBIN.xlsx]
2024-06-05 Incorporation of improved MT88xx library
    Further stability enhancements and the Incorporation of newest version of the MT88xx library. Included PS/2 Version now compatible with all previous hardware.
    [C64_keyboard.ino, C64keyboard.cpp, C64keyboard.h]
2024-06-25 Improved Key Maps and Bug Fix
    Key maps have been greatly improved. Various improvements and bug fixes.
    Basic key mapping description text file added.
    [C64_keyboard.ino, C64keyboard.cpp, C64keyboard.h, keymapping.h]
2024-06-27 SEEED XAIO SAMD21 Board & Key map improvements
    Seeed XIAO no longer needs a separate USB Host library. The Board driver includes it. The custom modifications are Instantiated from the board driver.
    Key mapping improvements and Bug Fixes.
    [C64_keyboard.ino, C64keyboard.cpp, C64keyboard.h, CustomHIDBoot.cpp, CustomHIDBoot.h, keymapping.h]
2024-07-02 Fix keymapping on PS/2
    PS/2 keymapping had not been fully updated to new mapping. Changed flag for restore key as some board libraries returned errors with it set at 255.
    [C64keyboard.cpp, keymapping.h]
2024-07-09 No bit change check and keymap value bug avoidance
    Added fail flag for bit position function. Changed keymap restore flag to 101 due to some compilers complaining about a value of 255.
    [C64keyboard.cpp, keymapping.h]
